ea-oskolkov/air_analyzer/3d/stand.stl

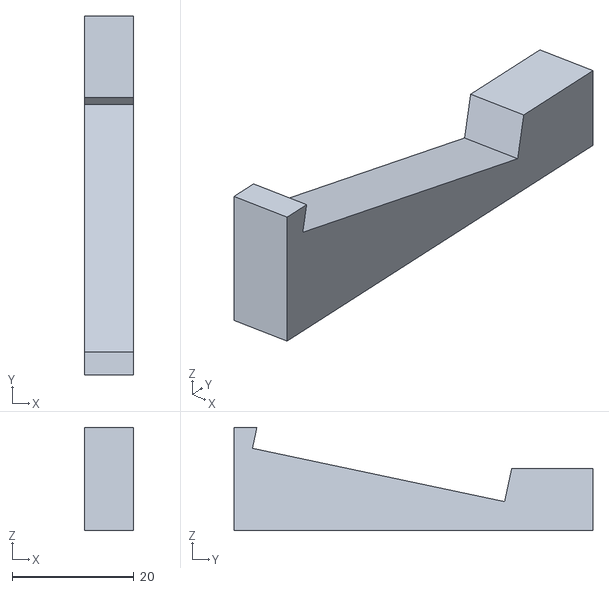
[picture p6: CAD file, 2026-10-18]
3d/stand.stl
8.00 x 59.0 x 17.0
