ea-oskolkov/air_analyzer/3d/back.stl

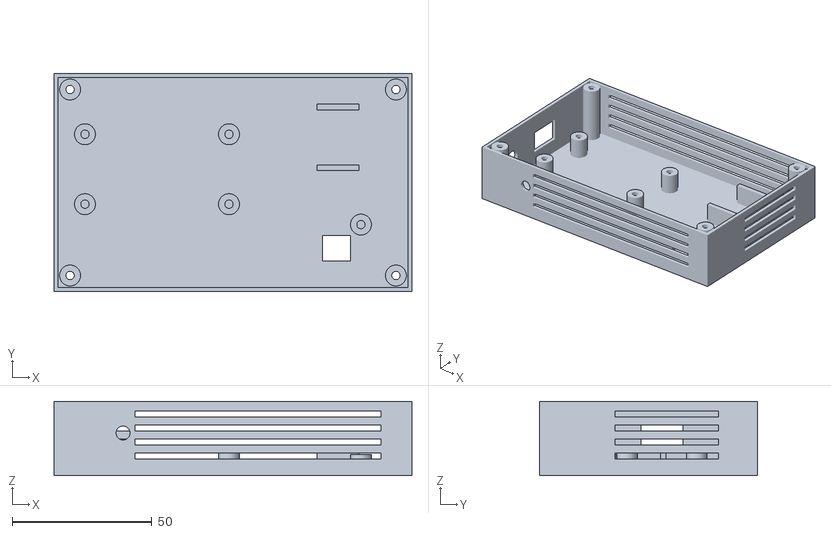
[picture p7: CAD file, 2026-10-18]
3d/back.stl
128.0 x 78.0 x 26.5
