ea-oskolkov/air_analyzer/3d/front.stl

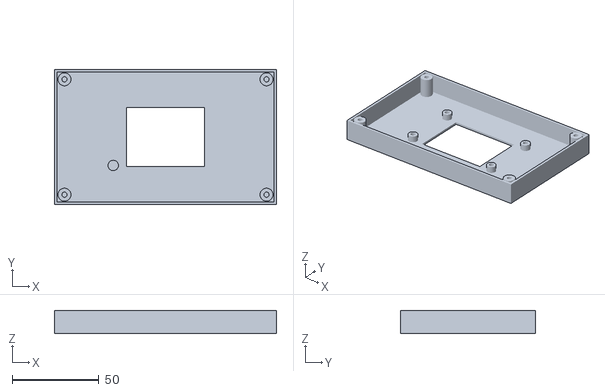
[picture p8: CAD file, 2026-10-18]
3d/front.stl
128.0 x 78.0 x 13.5
